terriko/pricklypear/(notices)

Notices in the files:
PricklyPear/PricklyPear.kicad_pcb:
CC-BY-SA 4.0
